proyectoitsv/2026_ECO-YPF/Codigo_integrado/.plans/etapa-7.md

# Etapa 7 — Documentación y cierre

Leer primero `.plans/README.md` (contexto, hallazgos y decisiones de diseño).

Actualizar `.plans/README.md` (estado final, decisiones tomadas, pendientes), breve `README`/comentarios de cabecera en `main.cpp` con mapa tarea→origen→periodo→core; confirmar que los 4 `main *.cpp` originales siguen sin cambios.

## Al terminar
- Correr `pio run` (debe salir con código 0).
- Tildar la etapa en `.plans/README.md` y anotar notas de traspaso (qué se movió/creó, desvíos del plan, pendientes).
