proyectoitsv/2026_ECO-YPF/(list of files, drawings)

Other design files:
Esquematico_Proteus/Esquema_proyecto_ECOYPF_2026.pdsprj [20260705, 02-50-25].pdsprj
