proyectoitsv/2026_ECO-YPF/Codigo_integrado/src/main GPS.cpp

#include <Arduino.h>
#include "Sensores/Tension/Tension.h"
#include "Sensores/Temperatura/Temperatura.h"
#include "Sensores/Inductivo(velocidad)/Inductivo.h"
#include "Sensores/GPS/GPS.h"

// --- CONFIGURACIÓN SENSOR INDUCTIVO ---
const int pinSensorInductivo = 26;
const int pulsosPorRevolucion = 1;
const float diametroRuedaMetros = 0.49;

float tiempoSegundos1 = 0.0f;
float circunferencia = 3.141592 * diametroRuedaMetros;
float rpm = 0.0;
float VelocidadMs = 0.0;
float velocidadKmH = 0.0;

// ISR para el sensor inductivo
int tiempoActual = 0;
int tiempoInicio = 0;
int tiempoGuardado = 0;
bool calculo = 0;

void IRAM_ATTR cuentaPulsos() {
    tiempoActual = millis();
    tiempoGuardado = tiempoActual - tiempoInicio;
    calculo = 1;
    tiempoInicio = millis();
}

// Objetos globales de temperatura
GestorTemperatura sensorTemp1(25);
GestorTemperatura sensorTemp2(33);

// Datos del GPS
DatosGPS datosGPS;

// --- UART1 reasignado a pines físicos ---
HardwareSerial SerialUART1(1); // Usa el periférico UART1 del ESP32

bool estadoPin = false;

void setup() {
    Serial.begin(115200);
    millis();

    // Configuración Batería
    pinMode(34, INPUT);

    // Configuración Temperatura
    sensorTemp1.inicializar();
    sensorTemp2.inicializar();

    // Configuración Inductivo (Velocidad)
    pinMode(pinSensorInductivo, INPUT);
    attachInterrupt(digitalPinToInterrupt(pinSensorInductivo), cuentaPulsos, RISING);

    // Configuración GPS
    inicializarGPS();

    // Configuración UART1 (RX=13, TX=14)
    SerialUART1.begin(9600, SERIAL_8N1, 13, 14);
}

void loop() {
    /*
    // 1. Lectura de Batería
    MedidaTension datos = leerTensionCompleta();

    Serial.print("Voltaje: ");
    Serial.print(datos.voltaje, 3);
    Serial.print(" V | ADC: ");
    Serial.print(datos.adc_crudo);
    Serial.print(" | Tensión Batería: ");
    Serial.print(datos.voltajeBateria, 2);
    Serial.print(" V | ");
    Serial.print(datos.porcentaje);
    Serial.println(" % | ");
    */

    // 2. Lectura de Temperatura
    sensorTemp1.solicitarTemperaturas();
    sensorTemp2.solicitarTemperaturas();

    float temp1 = sensorTemp1.leerTemperatura(0);
    float temp2 = sensorTemp2.leerTemperatura(0);
    float promedio = (temp1 + temp2) / 2.0;

    // 3. Lectura de Inductivo (Velocidad)
    /* if (calculo)
        {
        if (tiempoGuardado > 30)
            {
            VelocidadMs = 1539.38 / tiempoGuardado; // (2*pi*r)/T;
            velocidadKmH = VelocidadMs * 3600 / 1000;
            Serial.print(" | Velocidad: "); Serial.print(velocidadKmH, 1);
            Serial.print(" km/h");
            Serial.print(" | Tiempo: "); Serial.println(tiempoGuardado, 2);
            }
        calculo = 0;
        }
    delay(100); */

    // 4. GPS
    actualizarGPS();
    if (datosGPSActualizados()) {
        datosGPS = obtenerDatosGPS();

        Serial.print("LAT: ");
        Serial.print(datosGPS.latitud, 6);
        Serial.print(" | LONG: ");
        Serial.println(datosGPS.longitud, 6);

        Serial.print("SPEED: ");
        Serial.print(datosGPS.velocidadKmH, 2);
        Serial.print(" km/h | RUMBO: ");
        if (datosGPS.rumboValido) {
            Serial.print(datosGPS.rumboGrados, 1);
            Serial.println("°");
        } else {
            Serial.println("Sin rumbo");
        }

        Serial.print("HDOP: ");
        Serial.print(datosGPS.hdop);
        Serial.print(" | Satélites: ");
        Serial.println(datosGPS.satelites);

        char bufferFechaHora[30];
        snprintf(bufferFechaHora, sizeof(bufferFechaHora), "HORA ARG: %04d/%02d/%02d %02d:%02d:%02d",
                 datosGPS.anio, datosGPS.mes, datosGPS.dia,
                 datosGPS.hora, datosGPS.minuto, datosGPS.segundo);
        Serial.println(bufferFechaHora);

        Serial.println("----------------------------------------");
    }

    // 5. UART1 (ejemplo de uso, ajustar según el dispositivo real)
    /*if (SerialUART1.available()) {
        byte dato = SerialUART1.read();
        Serial.print("UART1 recibido: ");
        Serial.println(dato, HEX);
    }*/
}
