proyectoitsv/2026_ECO-YPF/Codigo_integrado/src/Sensores/Tension/Tension.h

#ifndef TENSION_H
#define TENSION_H
#include <stdint.h>
#include "../../Configuracion.h"

struct MedidaTension {
    // Campos anteriores conservados para compatibilidad.
    float voltaje;          // Entrada utilizada para convertir.
    int adc;
    float porcentaje;      // Indicador por tensión; NO es el SOC energético.
    float voltajeBateria;  // Pack equivalente en volts.
    int adc_crudo;
    float voltajePinV;     // Promedio antes de limitar/escalonar.
    uint32_t ultimaLecturaMs;
    bool lista;
    bool valida;
};

// Dos puntos de la escala del circuito existente. Sin limitar: la validez
// de la entrada se comprueba antes de usar el resultado.
inline float tensionPackDesdeVoltajePin(float voltajePinV) {
    return Config::PACK_MIN_V +
        (voltajePinV - Config::ENTRADA_TENSION_MIN_V) *
        (Config::PACK_MAX_V - Config::PACK_MIN_V) /
        (Config::ENTRADA_TENSION_MAX_V - Config::ENTRADA_TENSION_MIN_V);
}
void inicializarTension();
MedidaTension leerTensionCompleta(); // No espera; conserva la última lectura.
#endif
