proyectoitsv/2026_ECO-YPF/(commit log)

2026-05-18 Agrega archivo de feedback
2026-05-18 docs: Se agrega informe de Anteproyecto
2026-06-03 feat: Se añade codigo de prueba de sensor inductivo
2026-06-03 feat: Se añade codigo de prueba de sensor de temperatura
2026-07-05 Esquematicos de Proteus y Codigo integrado
    [esp32_dev_kit_v1_asm.stp]
2026-07-05 Codigo integrado y Esquematico Proteus
    [Esquema_proyecto_ECOYPF_2026.pdsprj [20260705, 02-50-25].pdsprj]
2026-07-20 agrego Temperatura.h y gitignore
2026-07-20 Adicion de librerias de Temperatura y medicion de temperatura
2026-07-23 correccion de la medicion de tension
2026-07-23 Calibracion del codigo de tension
2026-07-23 Esquematico de proteus actualizado
    [Esquema_proyecto_ECOYPF_2026.pdsprj [20260705, 02-50-25].pdsprj]
2026-07-23 Adicion de archivos de corriente y inductivo
2026-07-27 Correccion de codigo de sensor de temperatura
2026-07-27 Medicion del sensor inductivo
2026-07-28 correccion del codigo del sensor inductivo
2026-07-29 Feat: Se agrega interrupcion con timer para Inductivo
2026-09-14 Adicion de archivos de GPS
2026-09-16 Update Tension.cpp calibrado y main
2026-09-17 Adición de libreria RTC
2026-09-23 Adición librería GPS y adaptación de GPS.ino a GPS.cpp y GPS.h
2026-09-23 Adicioón Código GPS Correcto, Actualizado a fecha argentina, y correccion de rumbo cambiante estando quieto
    [GPS.cpp, GPS.h, main.cpp]
2026-09-30 Feat: UART1 reasignado a pines 4 y 5
2026-09-30 Update pines uart1 en main
2026-10-01 Primer Commit de FreeRTOS
